jbeuckm/808-Cymbale/eagle/808_CY.brd

## EAGLE design eagle/808_CY.brd (2016-04-25)

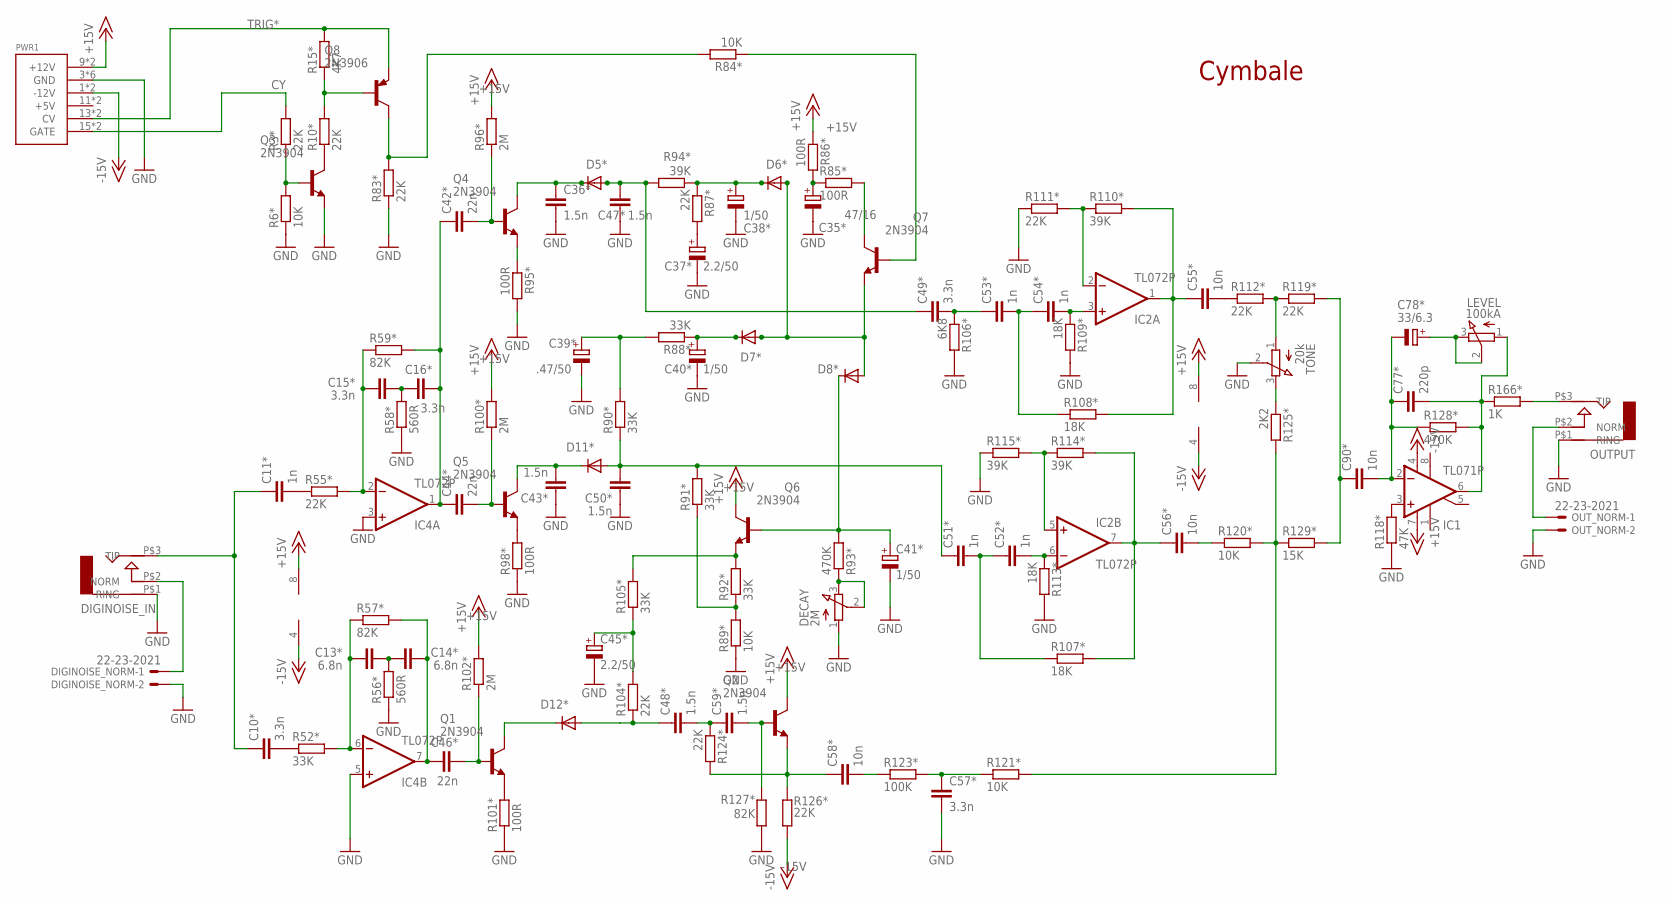
[picture p1: schematic 808_CY.sch]

Parts:
C10*, C15*, C16*, C49*, C57*: 3.3n; C035-025X75
C11*, C51*, C52*, C53*, C54*: 1n; C035-025X75
C13*, C14*: 6.8n; C035-030X60
C35*: 47/16; E2,5-5
C36*, C43*, C48*, C50*, C59*: 1.5n; C035-025X75
C37*, C45*: 2.2/50; E2,5-5
C38*, C40*: 1/50; E2,5-5
C39*: .47/50; E2,5-5
C41*: 1/50; E3,5-8
C42*, C44*, C46*: 22n; C050-024X044
C47*: 1.5n; C050-035X075
C55*: 10n; C050-030X075
C56*, C58*, C90*: 10n; C035-025X75
C77*: 220p; C025-025X050
C78*: 33/6.3; E3,5-8
D5*: 1N4148DO35-10; DO35-10
D6*, D7*, D8*, D11*, D12*: 1N4148DO35-7; DO35-7
DECAY: 2M; 3RP/1610N
DIGINOISE_IN: AUDIO-JACK; ERTHENVAR-JACK-90DEG
DIGINOISE_NORM: 22-23-2021
IC1: TL071P; DIL08
IC2, IC4: TL072P; DIL08
LEVEL: 100kA; 3RP/1610N
OUTPUT: AUDIO-JACK; ERTHENVAR-JACK-90DEG
OUT_NORM: 22-23-2021
PWR1: POWER; POWER_16
Q1, Q2, Q3, Q4, Q5, Q6, Q7: 2N3904; TO92
Q8: 2N3906; TO92
R3*, R10*, R83*, R87*, R104*, R112*, R119*, R124*: 22K; 0207/5V
R6*, R120*: 10K; 0207/5V
R15*: 4K7; 0207/5V
R52*, R88*, R90*: 33K; 0207/5V
R55*, R111*, R126*: 22K; 0207/7
R56*: 560R; 0207/5V
R57*, R127*: 82K; 0207/5V
R58*: 560R; 0207/7
R59*: 82K; 0207/2V
R84*, R89*, R121*: 10K; 0207/7
R85*, R86*, R95*, R98*, R101*: 100R; 0207/7
R91*, R92*: 33K; 0207/7
R93*: 470K; 0207/7
R94*, R114*: 39K; 0207/5V
R96*: 2M; 0207/5V
R100*, R102*: 2M; 0207/7
R105*: 33K; 0309/10
R106*: 6K8; 0207/5V
R107*, R108*: 18K; 0207/5V
R109*, R113*: 18K; 0207/7
R110*, R115*: 39K; 0207/7
R118*: 47K; 0207/5V
R123*: 100K; 0207/7
R125*: 2K2; 0207/5V
R128*: 470K; 0207/5V
R129*: 15K; 0207/5V
R166*: 1K; 0207/7
TONE: 20k; 3RP/1610N

Connections:
+15V: IC1.7 (V+), IC2.8 (V+), IC4.8 (V+), PWR1.9 (+12V), PWR1.10 (+12V), Q2.1 (C), Q6.1 (C), R86*.1, R96*.2, R100*.2, R102*.2
-15V: IC1.4 (V-), IC2.4 (V-), IC4.4 (V-), PWR1.1 (-12V), PWR1.2 (-12V), R126*.2
CY: PWR1.15 (GATE), PWR1.16 (GATE), R3*.2
GND: C35*.-, C36*.P$2 (2), C37*.-, C38*.-, C39*.-, C40*.-, C41*.-, C43*.P$1 (1), C45*.-, C47*.2, C50*.P$1 (1), C57*.P$2 (2), DECAY.1 (A), DIGINOISE_IN.P$1 (RING), DIGINOISE_NORM.2, IC4.3 (+IN), IC4.5 (+IN), OUTPUT.P$1 (RING), OUT_NORM.2, PWR1.3 (GND), PWR1.4 (GND), PWR1.5 (GND), PWR1.6 (GND), PWR1.7 (GND), PWR1.8 (GND), Q3.3 (E), R6*.1, R56*.1, R58*.1, R83*.1, R89*.1, R95*.2, R98*.1, R101*.1, R106*.2, R109*.2, R111*.1, R113*.2, R115*.1, R118*.1, R127*.2, TONE.2 (S)
LT_LC_OUT1: C10*.P$1 (1), C11*.P$1 (1), DIGINOISE_IN.P$3 (TIP)
unnamed: Q5.3 (E), R98*.2
unnamed: Q1.3 (E), R101*.2
unnamed: Q3.1 (C), R10*.1
unnamed: IC1.3 (+IN), R118*.2
unnamed: OUTPUT.P$2 (NORM), OUT_NORM.1
unnamed: DIGINOISE_IN.P$2 (NORM), DIGINOISE_NORM.1
unnamed: OUTPUT.P$3 (TIP), R166*.2
unnamed: C78*.+, LEVEL.2 (S), LEVEL.3 (E)
unnamed: C58*.P$1 (1), Q2.3 (E), R124*.2, R126*.1
unnamed: DECAY.2 (S), DECAY.3 (E), R93*.1
unnamed: Q4.3 (E), R95*.1
unnamed: C50*.P$2 (2), C51*.P$1 (1), D11*.A, R90*.1, R91*.2
unnamed: C11*.P$2 (2), R55*.1
unnamed: C15*.P$1 (1), IC4.2 (-IN), R55*.2, R59*.1
unnamed: C44*.2, Q5.2 (B), R100*.1
unnamed: C43*.P$2 (2), D11*.C, Q5.1 (C)
unnamed: C39*.+, R88*.2, R90*.2
unnamed: C10*.P$2 (2), R52*.1
unnamed: C13*.P$1 (1), IC4.6 (-IN), R52*.2, R57*.1
unnamed: C14*.P$2 (2), C46*.1, IC4.7 (OUT), R57*.2
unnamed: C46*.2, Q1.2 (B), R102*.1
unnamed: D12*.C, Q1.1 (C)
unnamed: C48*.P$1 (1), D12*.A, R104*.1
unnamed: C40*.+, D7*.C, R88*.1
unnamed: C35*.+, R85*.1, R86*.2
unnamed: Q7.1 (C), R85*.2
unnamed: D6*.A, D7*.A, D8*.A, Q7.3 (E)
unnamed: Q7.2 (B), R84*.1
unnamed: Q8.1 (C), R83*.2, R84*.2
unnamed: Q8.2 (B), R10*.2, R15*.1
unnamed: Q3.2 (B), R3*.1, R6*.2
unnamed: C36*.P$1 (1), D5*.C, Q4.1 (C)
unnamed: C47*.1, C49*.P$1 (1), D5*.A, R94*.2
unnamed: C42*.2, Q4.2 (B), R96*.1
unnamed: C37*.+, R87*.2
unnamed: Q6.3 (E), R92*.2, R105*.2
unnamed: R89*.2, R91*.1, R92*.1
unnamed: C41*.+, D8*.C, Q6.2 (B), R93*.2
unnamed: C49*.P$2 (2), C53*.P$1 (1), R106*.1
unnamed: C54*.P$2 (2), IC2.3 (+IN), R109*.1
unnamed: R112*.2, R119*.1, TONE.1 (A)
unnamed: C55*.1, IC2.1 (OUT), R108*.2, R110*.2
unnamed: C53*.P$2 (2), C54*.P$1 (1), R108*.1
unnamed: IC2.2 (-IN), R110*.1, R111*.2
unnamed: C55*.2, R112*.1
unnamed: R125*.1, TONE.3 (E)
unnamed: C52*.P$2 (2), IC2.6 (-IN), R113*.1
unnamed: C56*.P$1 (1), IC2.7 (OUT), R107*.2, R114*.2
unnamed: C51*.P$2 (2), C52*.P$1 (1), R107*.1
unnamed: IC2.5 (+IN), R114*.1, R115*.2
unnamed: C77*.1, C78*.-, C90*.P$2 (2), IC1.2 (-IN), R128*.1
unnamed: C77*.2, IC1.6 (OUT), LEVEL.1 (A), R128*.2, R166*.1
unnamed: C56*.P$2 (2), R120*.1
unnamed: R120*.2, R121*.2, R125*.2, R129*.1
unnamed: C90*.P$1 (1), R119*.2, R129*.2
unnamed: C48*.P$2 (2), C59*.P$1 (1), R124*.1
unnamed: C59*.P$2 (2), Q2.2 (B), R127*.1
unnamed: C58*.P$2 (2), R123*.1
unnamed: C57*.P$1 (1), R121*.1, R123*.2
unnamed: C15*.P$2 (2), C16*.P$1 (1), R58*.2
unnamed: C13*.P$2 (2), C14*.P$1 (1), R56*.2
unnamed: C45*.+, R104*.2, R105*.1
unnamed: C38*.+, D6*.C, R87*.1, R94*.1
TO_HH: C16*.P$2 (2), C42*.1, C44*.1, IC4.1 (OUT), R59*.2
TRIG*: PWR1.13 (CV), PWR1.14 (CV), Q8.3 (E), R15*.2

Notes on the sheet:
Cymbale

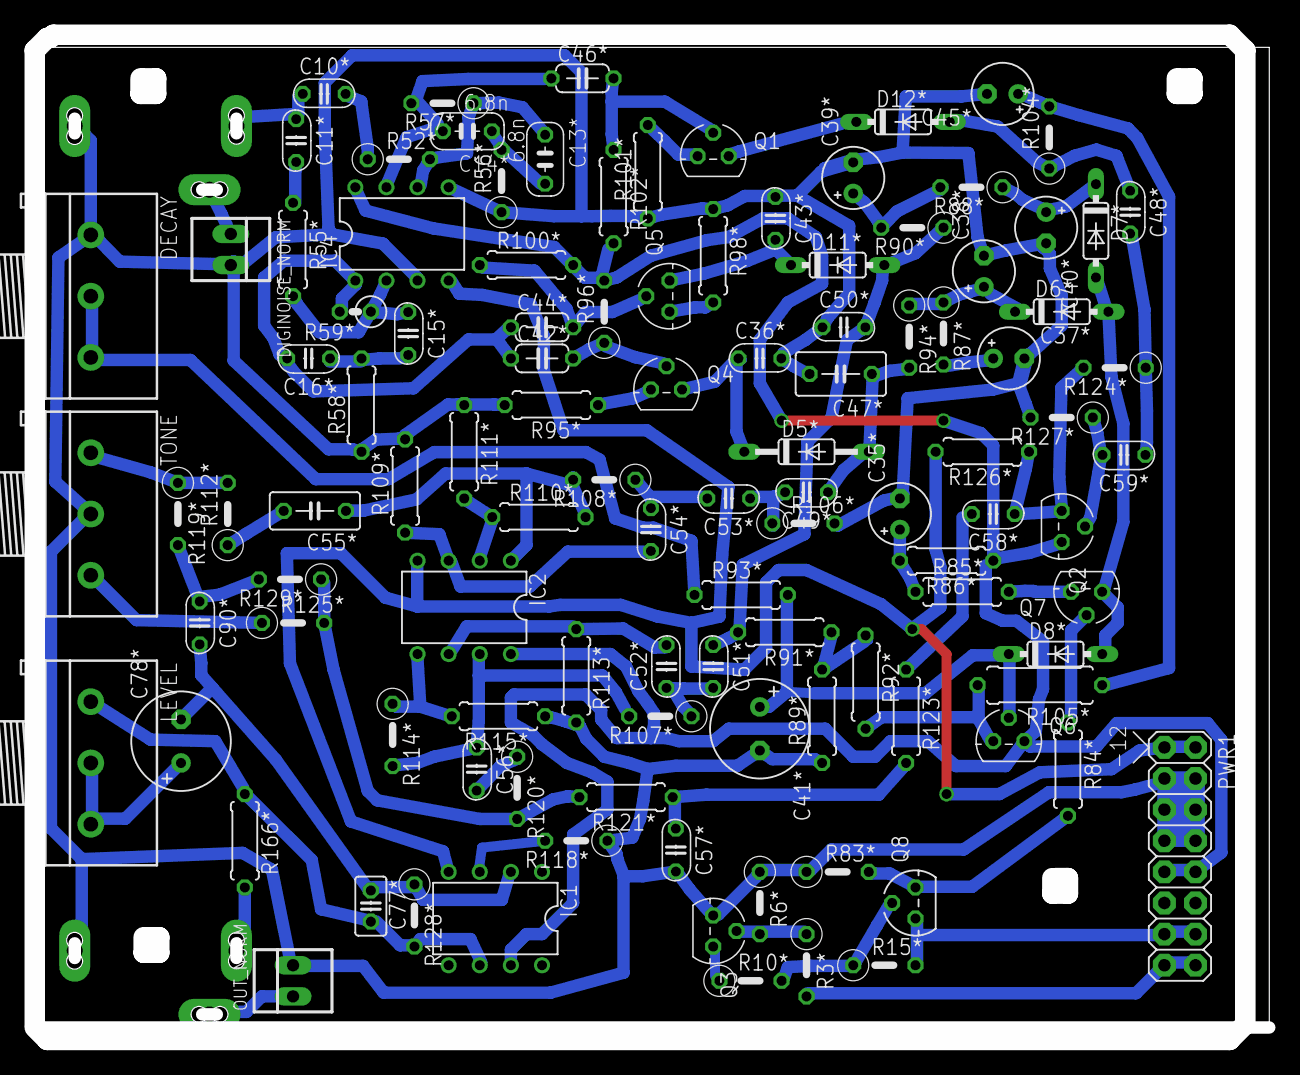
[picture p2: board 808_CY.brd from above]

Board: 2 copper layers, 100.8 x 82.0 mm, 111 parts (0 on the bottom side), 70 nets.
