jbeuckm/808-Cymbale/(commit log)

2016-04-19 subbed opamps
    [808_CY.sch]
2016-04-19 moved diginoise off-board
    [808_CY.sch]
2016-04-19 corrected bad connection on 071s
    [808_CY.sch]
2016-04-19 starting the layout
    [808_CY.brd]
2016-04-20 consolidated double 1m resistors
    [808_CY.sch]
2016-04-20 third of the parts on
    [808_CY.brd, 808_CY.sch]
2016-04-20 parts on the board
    [808_CY.brd]
2016-04-20 90 pct routed
    [808_CY.brd, 808_CY.sch]
2016-04-21 trying a smaller width
    [808_CY.brd]
2016-04-21 finishing routes manually
    [808_CY.brd, 808_CY.sch]
2016-04-22 more routes
    [808_CY.brd, 808_CY.sch]
2016-04-22 ar 94pct with 072 replacing two 071
    [808_CY.brd, 808_CY.sch]
2016-04-23 finishing manually with two 072
    [808_CY.brd, 808_CY.sch]
2016-04-23 more manual routes
    [808_CY.brd, 808_CY.sch]
2016-04-23 routed and tweaked
    [808_CY.brd, 808_CY.sch]
2016-04-23 checked schemo and generated gcode
    [808_CY.brd, 808_CY.sch]
2016-04-24 will try gcode
    [808_CY.brd]
2016-04-25 tweaks aftrer working build
    [808_CY.brd, 808_CY.sch]
